tadeuszlorkowski/lorkowski-tup/caly_uklad_flippera.png

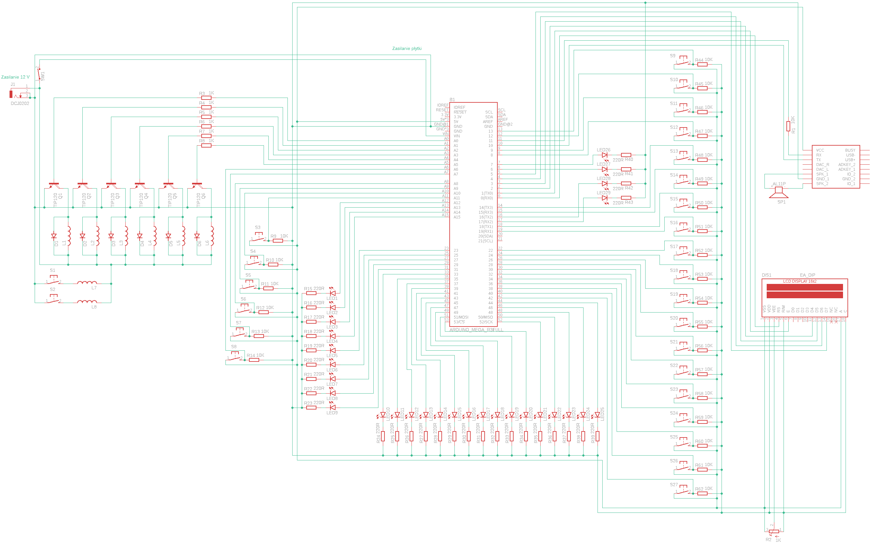
caly_uklad_flippera.png
